Hostilebaker/Flight_ComputerFC1/(commit log)

2026-07-05 Add pin definitions for CORTEX-10K FC
2026-07-06 Refine comments in pin_definitions.h
    Updated comments for buzzer and expansion port definitions to clarify setup requirements.
    [pin_definitions.h]
2026-07-08 update in imu vote logic
2026-08-05 Setup sensors and communication for flight control
    Initialized various sensors and communication protocols for rocket flight control.
2026-10-26 Add rocketFlightLoop.ino for flight control
    Implement rocket flight control logic with sensor integration and telemetry.
